DC423/Hardware/README.md

# Hardware

Hardware design and code are housed here.

2018-08 - [2018 DC423 Hardware Badge](https://github.com/DC423/Hardware/blob/master/DC423-2018-Tracer/README.md)
