DC423/Hardware/DC423-2018-Tracer/DC423-Tracer-V1.pdf

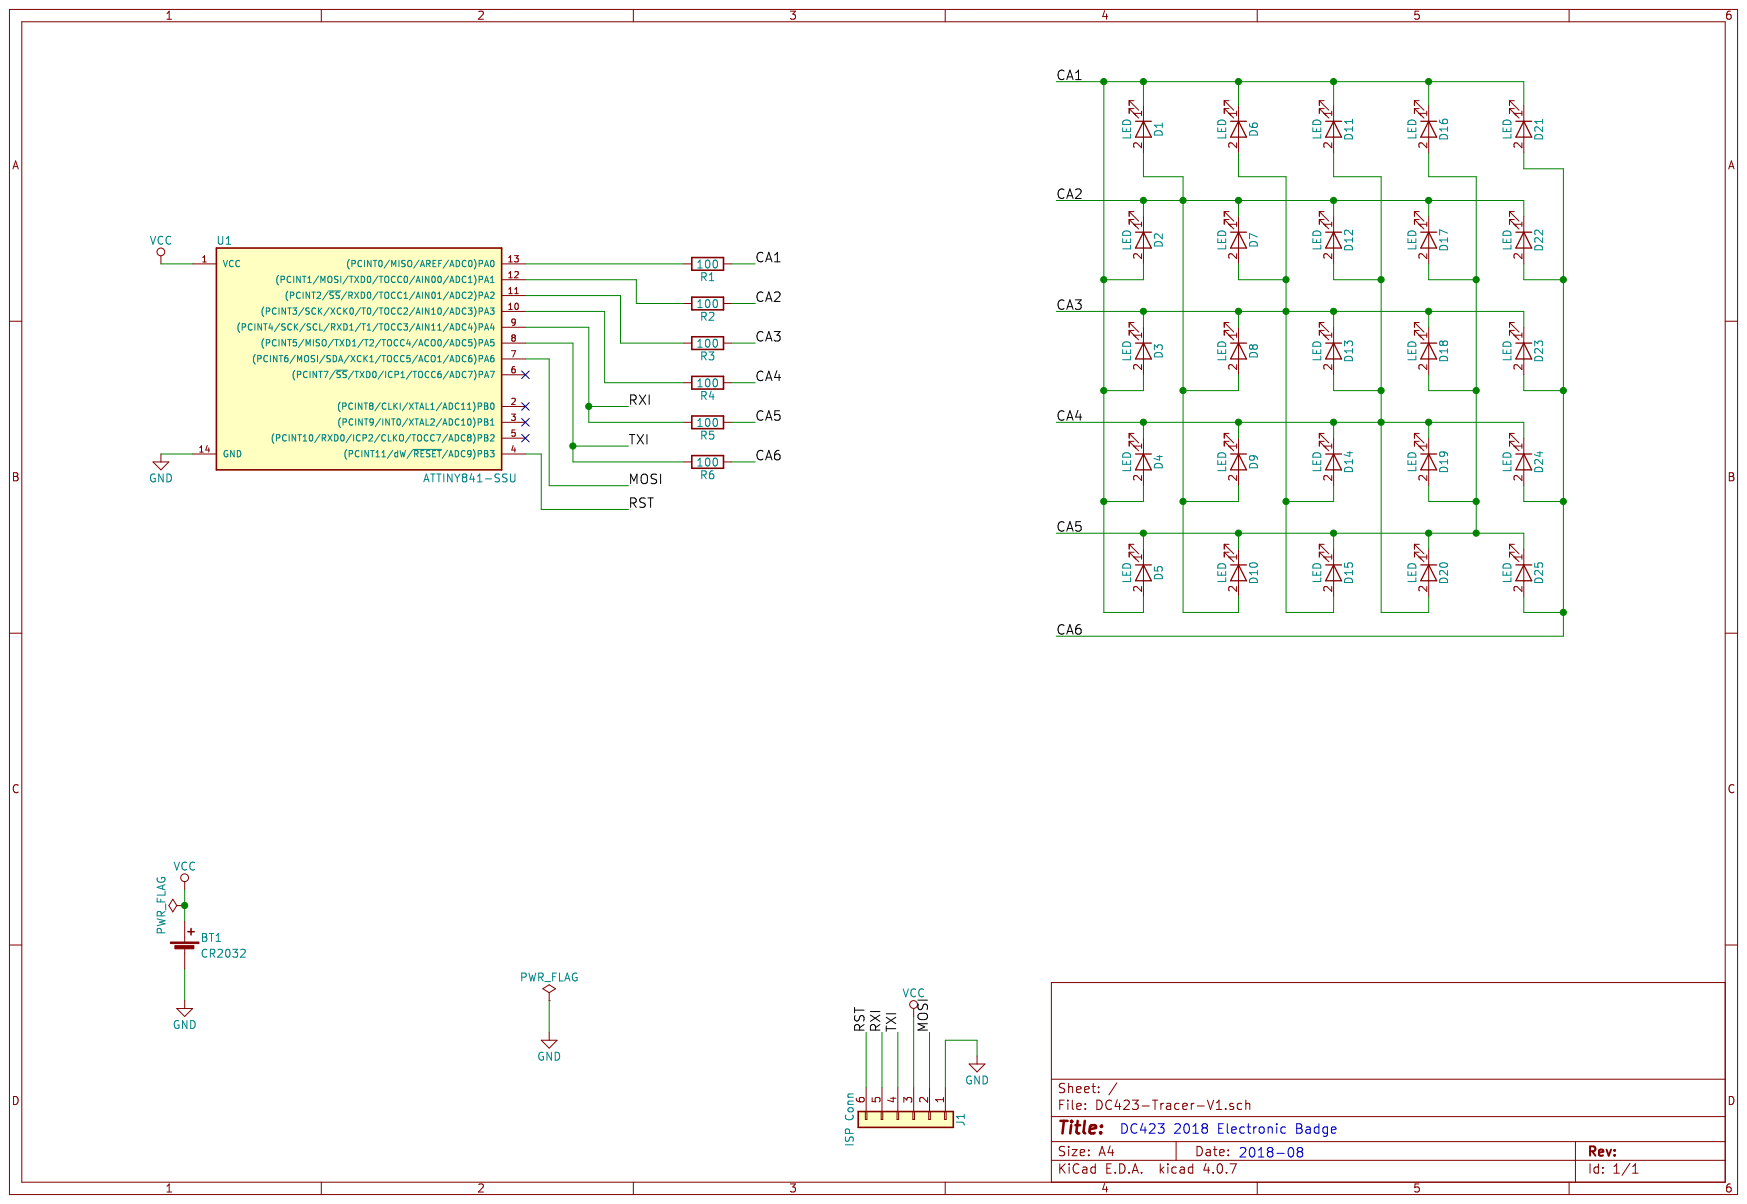
[picture p2: page 1]
