DC423/Hardware/DC423-2018-Tracer/DC423-Tracer-V1.kicad_pcb

## KiCad design DC423-2018-Tracer/DC423-Tracer-V1.kicad_pcb (2018-08-06)

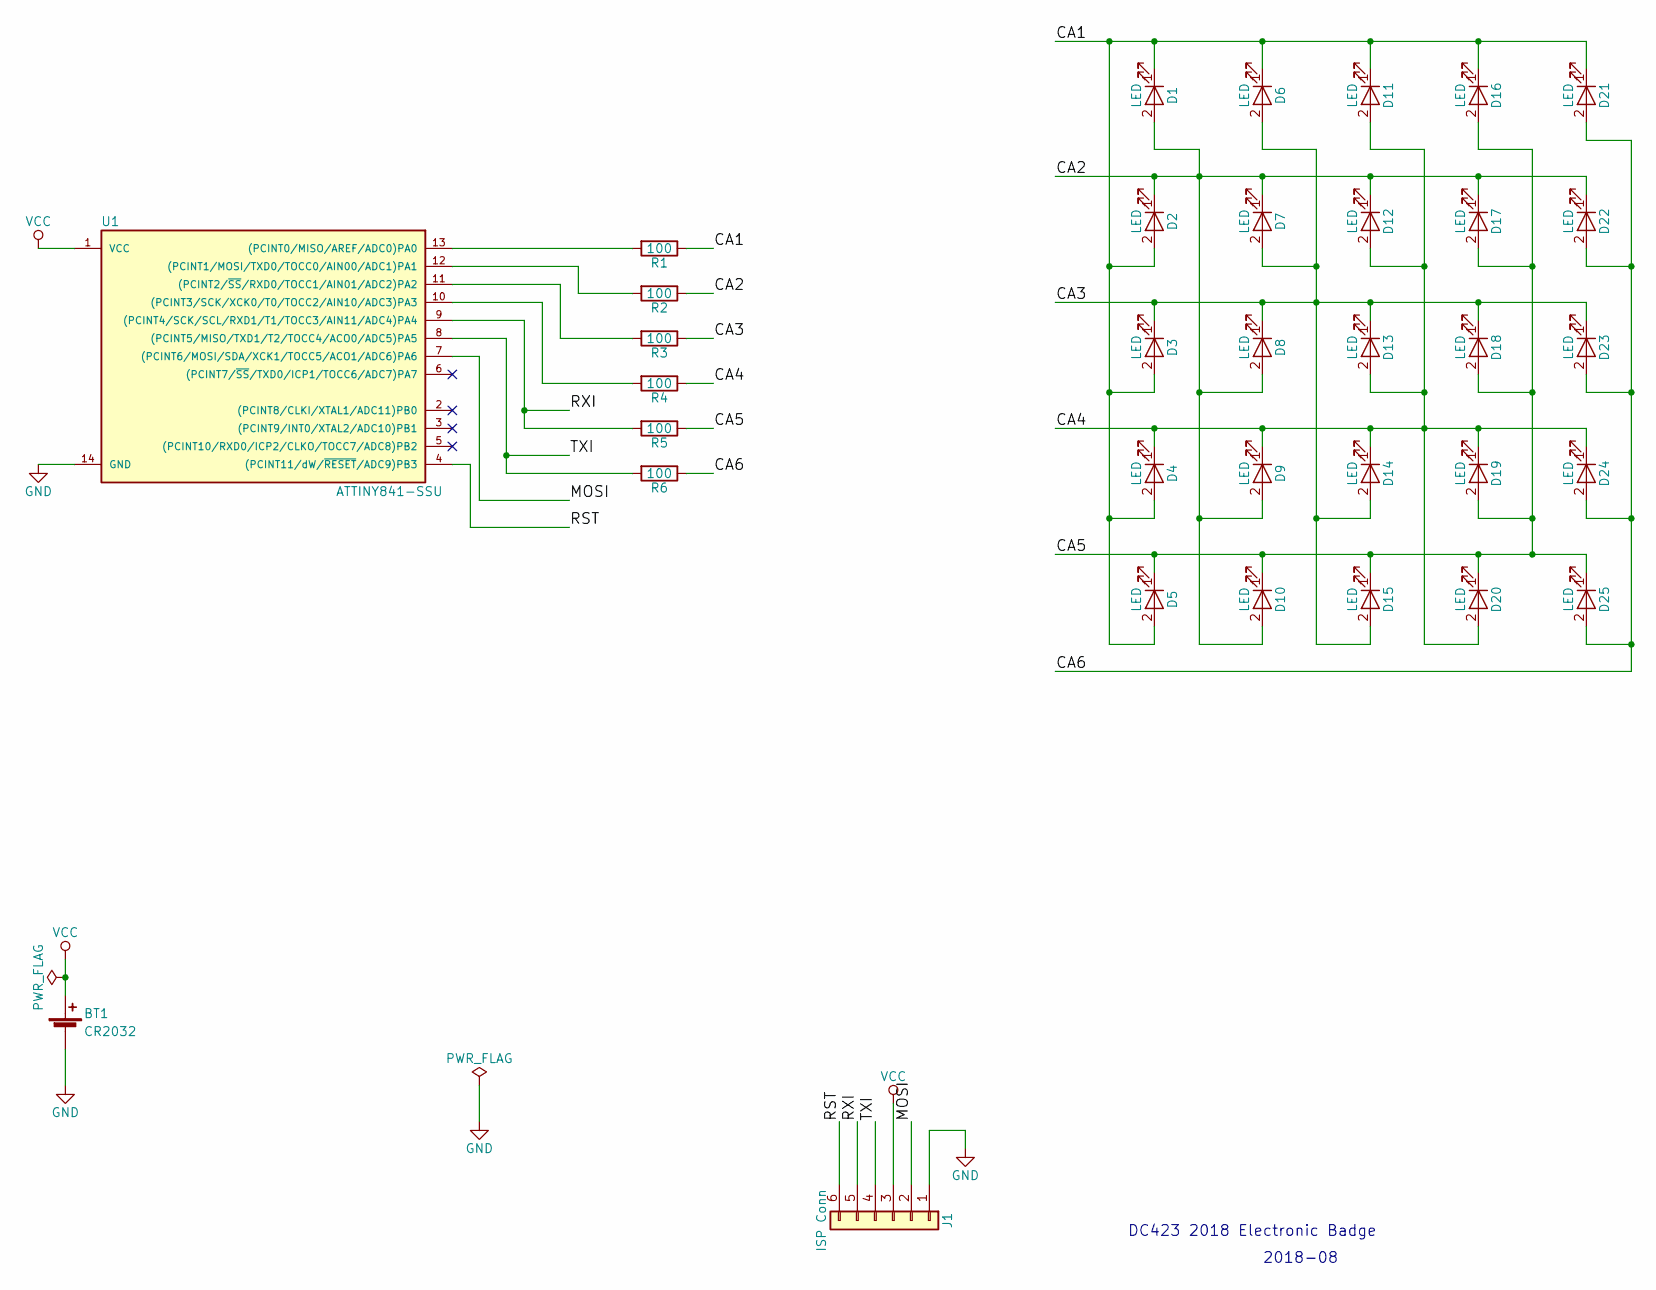
[picture p3: schematic DC423-Tracer-V1.sch]

Parts:
BT1: CR2032; linx-bat-hld-001
D1, D2, D3, D4, D5, D6, D7, D8, D9, D10, D11, D12, D13, D14, D15, D16, D17, D18, D19, D20, D21, D22, D23, D24, D25: LED; LED_1206
J1: ISP Conn; Pin_Header_Straight_1x06_Pitch2.54mm
R1, R2, R3, R4, R5, R6: 100; R_1206
U1: ATTINY841-SSU; SOIC-14_3.9x8.7mm_Pitch1.27mm

Connections:
/CA1: D1.1 (K), D2.2 (A), D3.2 (A), D4.2 (A), D5.2 (A), D6.1 (K), D11.1 (K), D16.1 (K), D21.1 (K), R1.1
/CA2: D1.2 (A), D2.1 (K), D7.1 (K), D8.2 (A), D9.2 (A), D10.2 (A), D12.1 (K), D17.1 (K), D22.1 (K), R2.1
/CA3: D3.1 (K), D6.2 (A), D7.2 (A), D8.1 (K), D13.1 (K), D14.2 (A), D15.2 (A), D18.1 (K), D23.1 (K), R3.1
/CA4: D4.1 (K), D9.1 (K), D11.2 (A), D12.2 (A), D13.2 (A), D14.1 (K), D19.1 (K), D20.2 (A), D24.1 (K), R4.1
/CA5: D5.1 (K), D10.1 (K), D15.1 (K), D16.2 (A), D17.2 (A), D18.2 (A), D19.2 (A), D20.1 (K), D25.1 (K), R5.1
/CA6: D21.2 (A), D22.2 (A), D23.2 (A), D24.2 (A), D25.2 (A), R6.1
/MOSI: J1.2, U1.7 ((PCINT6/MOSI/SDA/XCK1/TOCC5/ACO1/ADC6)P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)
/RST: J1.6, U1.4 ((PCINT11/dW/~RESET~/ADC9)PB3)
/RXI: J1.5, R5.2, U1.9 ((PCINT4/SCK/SCL/RXD1/T1/TOCC3/AIN11/ADC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)
/TXI: J1.4, R6.2, U1.8 ((PCINT5/MISO/TXD1/T2/TOCC4/ACO0/ADC5)PA5)
GND: BT1.2 (-), J1.1, U1.14 (GND)
unnamed: R1.2, U1.13 ((PCINT0/MISO/AREF/ADC0)PA0)
unnamed: R2.2, U1.12 ((PCINT1/MOSI/TXD0/TOCC0/AIN00/ADC1)PA1)
unnamed: R3.2, U1.11 ((PCINT2/~SS~/RXD0/TOCC1/AIN01/ADC2)PA2)
unnamed: R4.2, U1.10 ((PCINT3/SCK/XCK0/T0/TOCC2/AIN10/ADC3)PA3)
VCC: BT1.1 (+), J1.3, U1.1 (VCC)

Notes on the sheet:
DC423 2018 Electronic Badge
2018-08

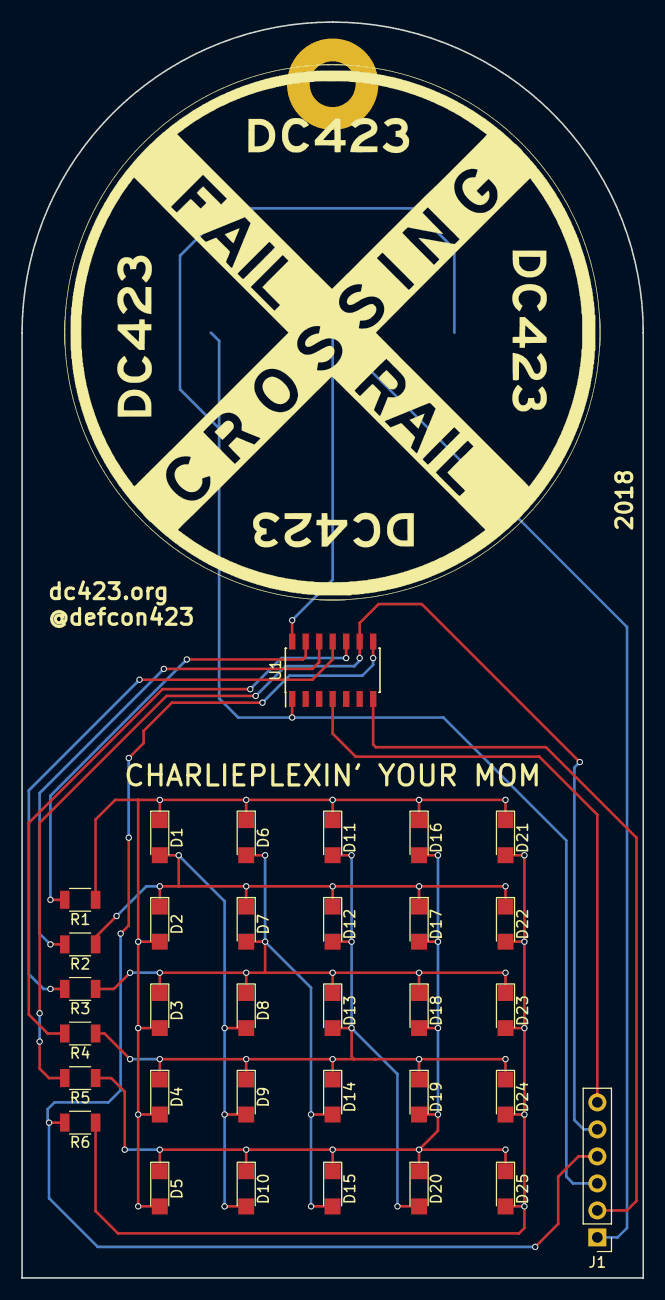
[picture p4: board DC423-Tracer-V1.kicad_pcb from above]

Board: 2 copper layers, 58.4 x 118.1 mm, 35 parts (1 on the bottom side), 16 nets.

Other parts of the board:
F***: FRail; failrail_2x2
