DC423/Hardware/(commit log)

2018-08-05 Initial commit of hardware repo
    [DC423-Tracer-V1.kicad_pcb, DC423-Tracer-V1.sch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]
2018-08-06 Final updates to schematic and added PDF of schematic
    [DC423-Tracer-V1.kicad_pcb, DC423-Tracer-V1.sch]
2018-09-28 added image of board
